GearDownForWhat/BalanceBot/IMG_2783.jpg

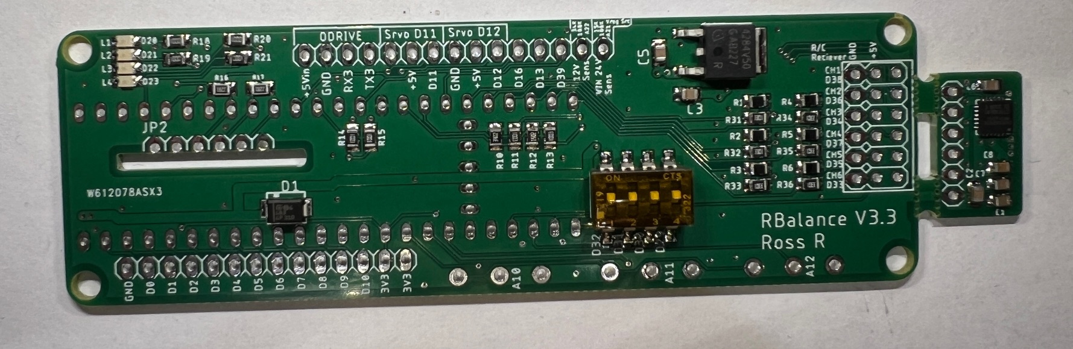
IMG_2783.jpg
