GearDownForWhat/BalanceBot/IMG_2785.jpg

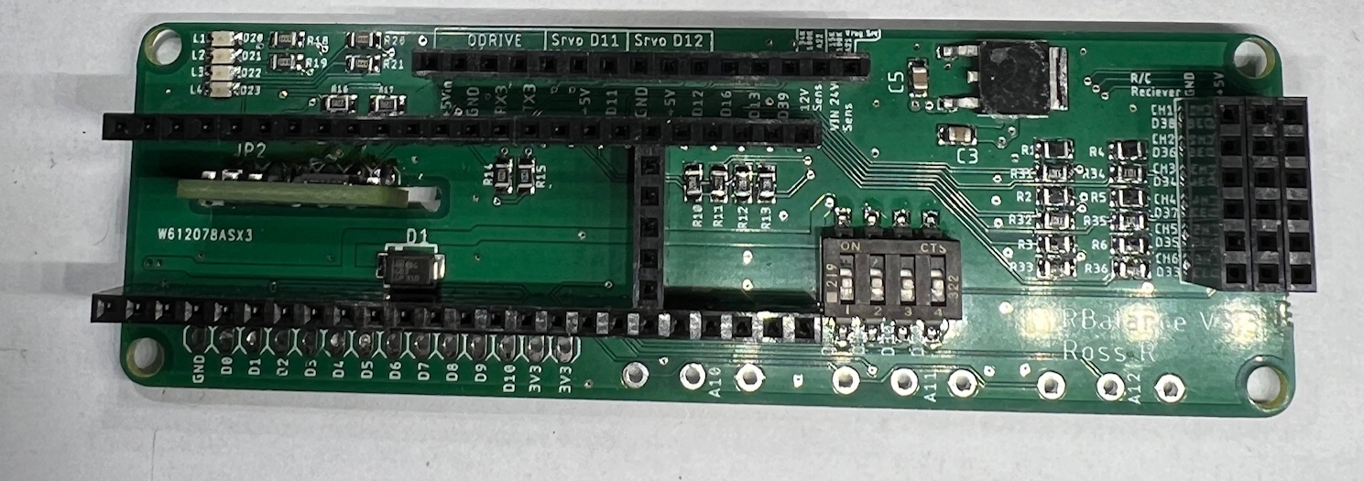
IMG_2785.jpg
