GearDownForWhat/BalanceBot/Balance Bot/BB Main Body.stl

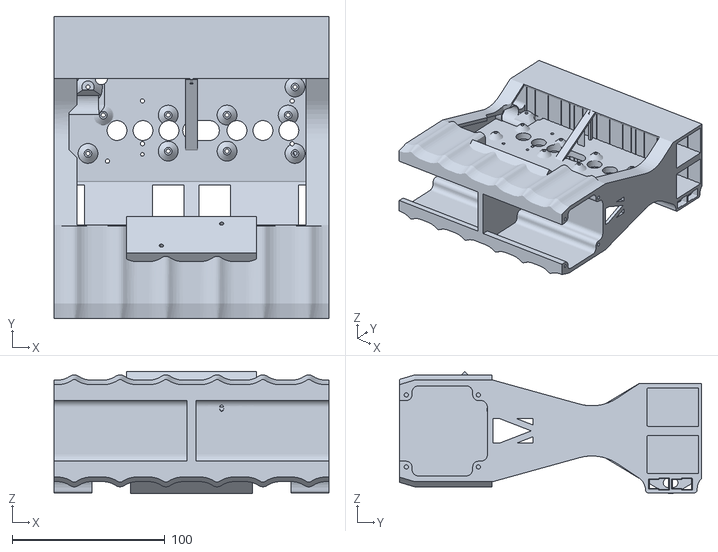
[picture p5: CAD file, 2024-02-02]
Balance Bot/BB Main Body.stl
180.0 x 198.0 x 79.9
