GearDownForWhat/BalanceBot/Balance Bot/BB Front Cover.stl

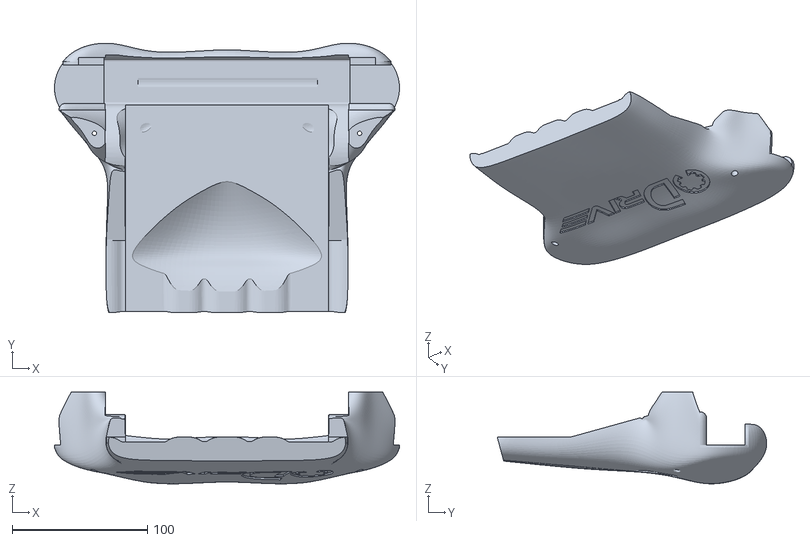
[picture p6: CAD file, 2024-02-02]
Balance Bot/BB Front Cover.stl
255.3 x 199.4 x 67.8
