GearDownForWhat/BalanceBot/Balance Bot/BB BAck Cover.stl

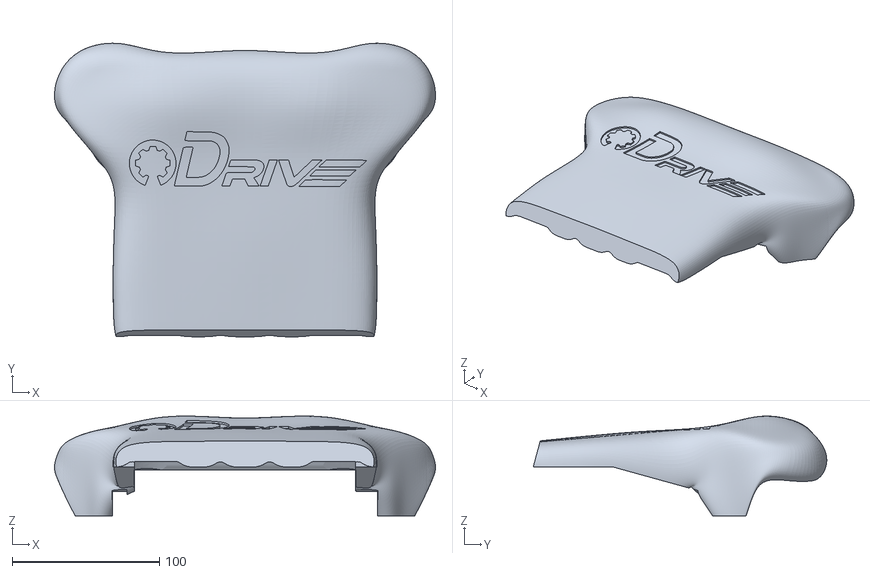
[picture p7: CAD file, 2024-02-02]
Balance Bot/BB BAck Cover.stl
258.8 x 199.4 x 67.8
