GearDownForWhat/BalanceBot/Balance Bot/BB Wheel Hub Adaptor.stl

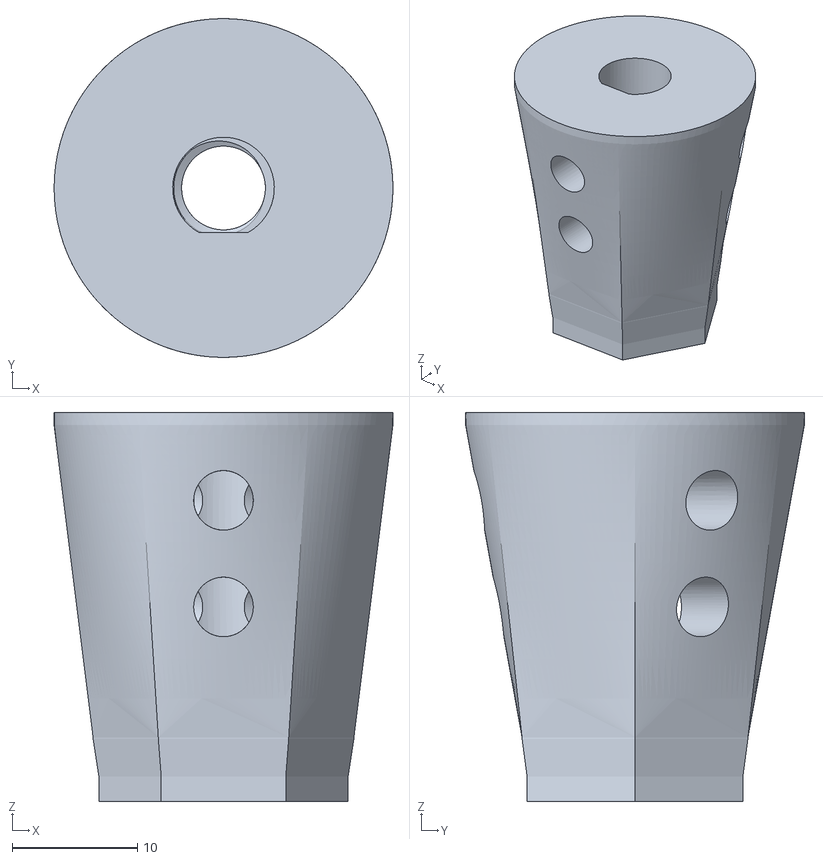
[picture p8: CAD file, 2024-02-02]
Balance Bot/BB Wheel Hub Adaptor.stl
27.0 x 27.0 x 31.0
