GearDownForWhat/BalanceBot/Balance Bot/Enclosure - Part 2 v1.stl

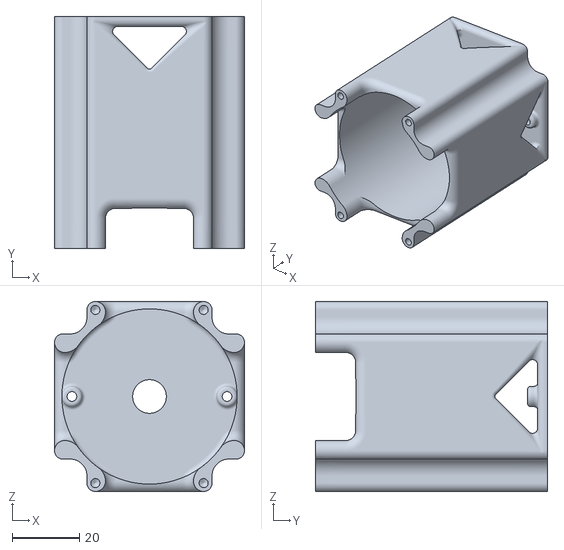
[picture p9: CAD file, 2019-05-11]
Balance Bot/Enclosure - Part 2 v1.stl
56.4 x 69.0 x 56.4
