GearDownForWhat/BalanceBot/Balance Bot/Enclosure - Part 3 v1.stl

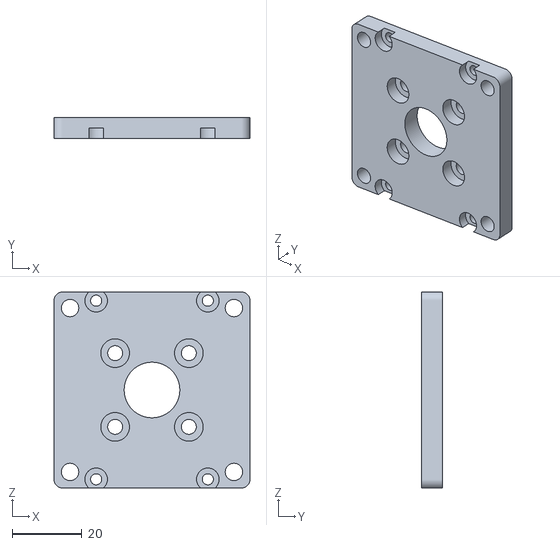
[picture p10: CAD file, 2019-05-11]
Balance Bot/Enclosure - Part 3 v1.stl
56.4 x 6.00 x 56.4
