GearDownForWhat/BalanceBot/Balance Bot/BB Wheel Hub Washer.stl

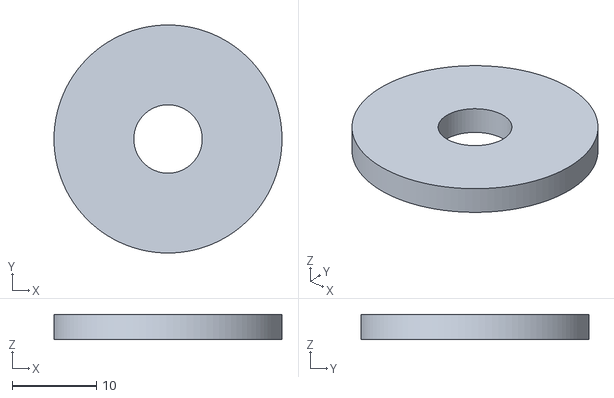
[picture p11: CAD file, 2024-02-02]
Balance Bot/BB Wheel Hub Washer.stl
27.0 x 27.0 x 3.00
