GearDownForWhat/BalanceBot/(list of files, cad)

Other CAD files:
Balance Bot/Wheel Washer.stl
