GearDownForWhat/BalanceBot/(threads)

Thread 1 (2019-05-10):

Hardware specs?

iplayfast, 2019-05-10:
Code is good, but in the last video, you've got a nano as well as a mega.  Does the code specify which process it is for? Also hardware used would be mildly useful :)
Links to relevant pages in a md format page would also be useful. The videos say your projects are on thingiverse so link to this projects thingiverse page would also be good. I wasn't able to find it.

As an idea, from your video description I'm not sure you are doing this, but if you have a pid driving the pid you can get dynamic "dead zones" something to look into.

GearDownForWhat, 2019-05-11:
Working on getting everything organized, we reduced the number of processors to 1.

What do you mean by dynamic deadzones?

iplayfast, 2019-05-12:
You mentioned in the video that by giving a deadzone the bot was more stable. You can make the dead zone move around depending on where you want the acceleration. The pid controlling that keeps things from going too crazy faster they you can react, so it's overall more controllable.

GearDownForWhat, 2019-05-14:
I actually removed the deadline from the program since I started using the Odrive, I think.

Closed 2019-05-24.

Thread 2 (2019-05-21):

Question: how about dirt/gravle roads?

jh83, 2019-05-21:
This post is a question and not related to any bug.

How well does the current version of the software handle driving on uneven surfaces like gravele/dirt roads? Does it manage the vibrations caused by the gravle and holes and such which might exist outside pavement roads?

GearDownForWhat, 2019-05-24:
It doesn't do well on low friction surfaces, for example on wet pavement it's very hard to control.

You could make it a bit more dependable on low friction surfaces by de-tuning the PID loops a bit

Closed 2019-05-24.
