GearDownForWhat/BalanceBot/(commit log)

2019-05-12 Add files via upload
    Added New Fritzing Drawing. Need to check for errors
    [Balance Bot Circuit.fzz]
2024-02-02 New Version
    Requires different PID library
2024-02-19 Add files via upload
    This is the Odrive Config
    [Odrive_backup_021924.json]
